cloudglides/FC/FC.png

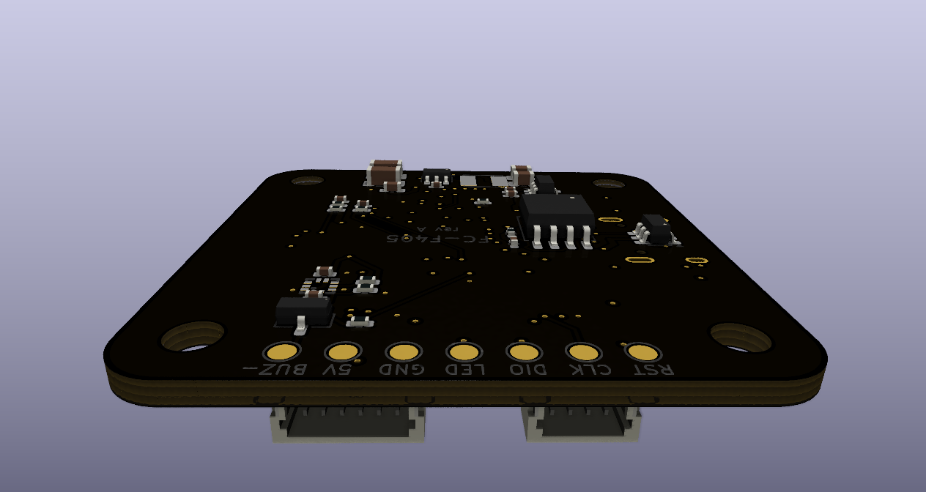
FC.png
