cloudglides/FC/journals/02-sch-parts-arranged-in-blocks/schematic.png

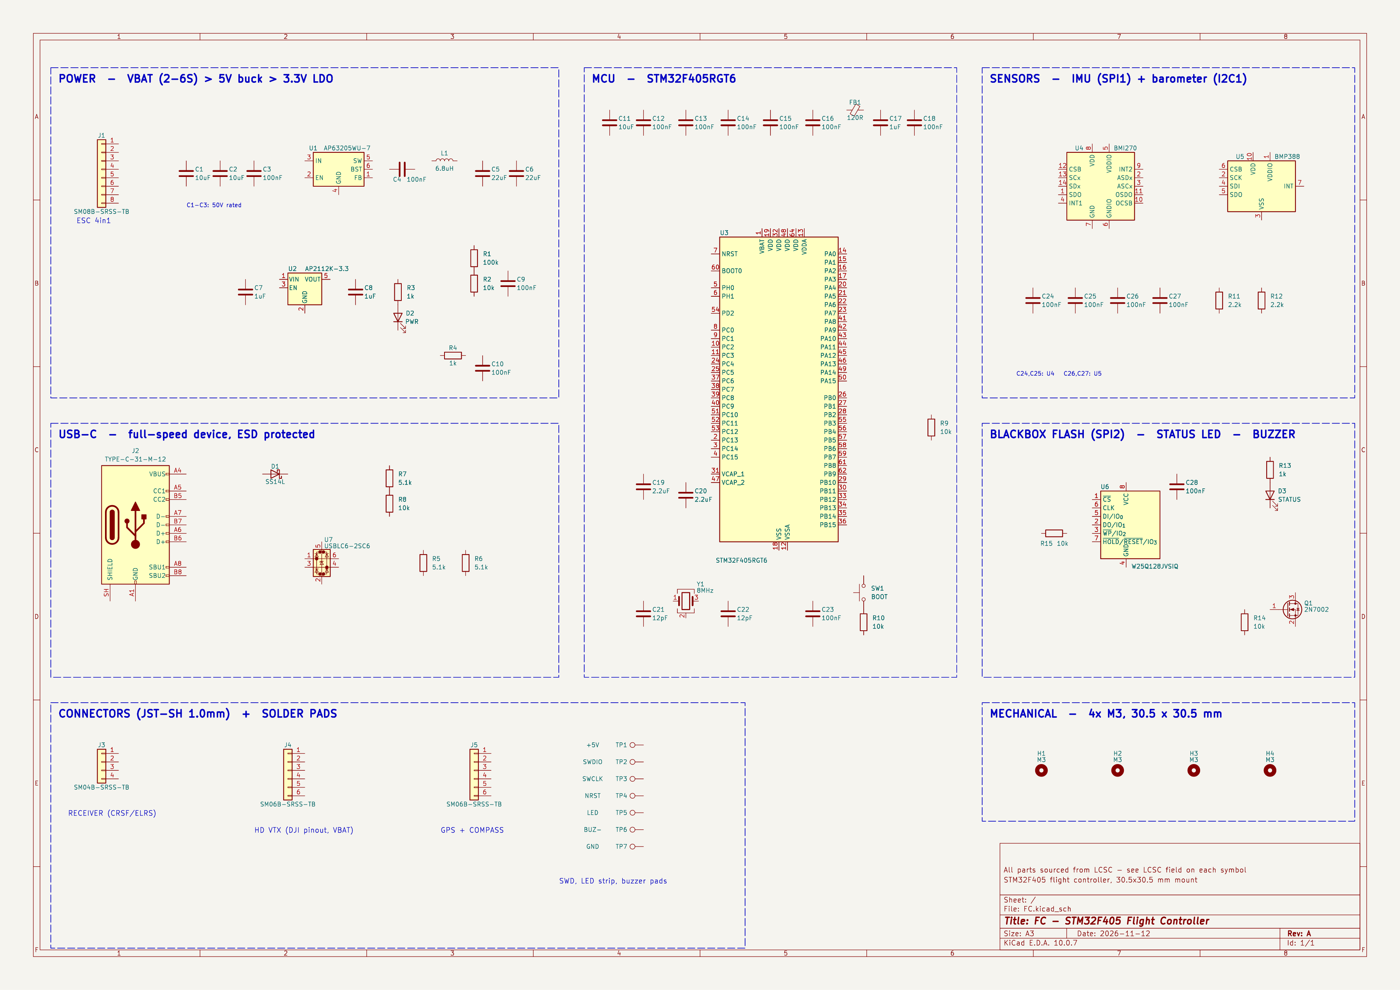
journals/02-sch-parts-arranged-in-blocks/schematic.png
