cloudglides/FC/journals/04-sch-usb-wired/schematic.png

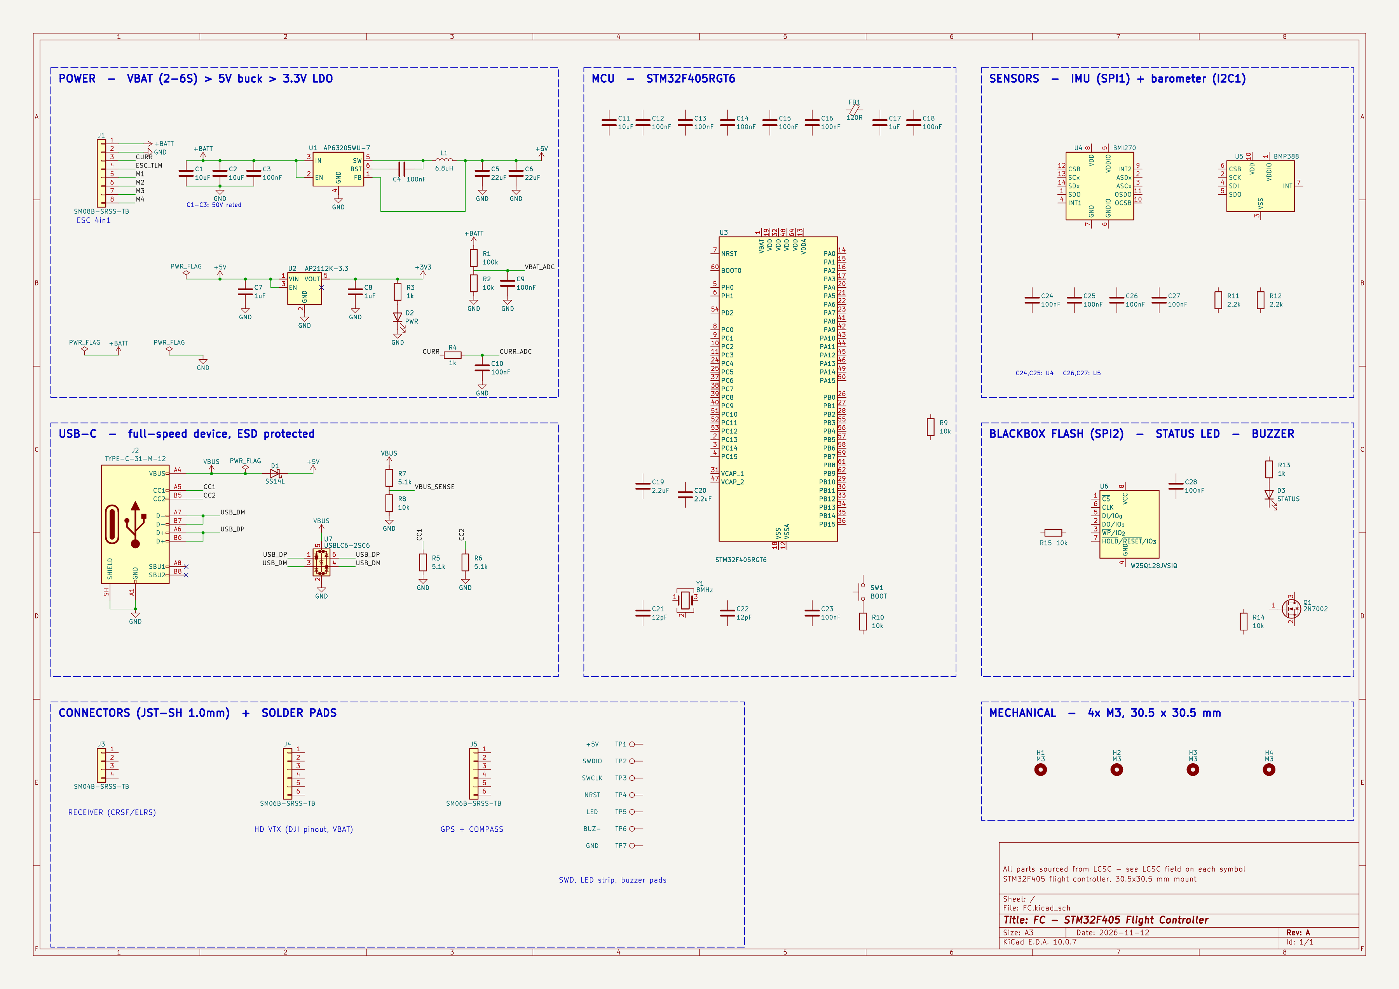
journals/04-sch-usb-wired/schematic.png
