cloudglides/FC/BOM.csv

Comment | Designator | Footprint | LCSC Part # | Quantity
10uF | C1,C2 | C_1206_3216Metric | C77092 | 2
100nF | C3 | C_0603_1608Metric | C14663 | 1
100nF | C4,C9,C10,C12,C13,C14,C15,C16,C18,C23,C24,C25,C26,C27,C28 | C_0402_1005Metric | C1525 | 15
22uF | C5,C6 | C_0805_2012Metric | C45783 | 2
1uF | C7,C8,C17 | C_0402_1005Metric | C52923 | 3
10uF | C11 | C_0603_1608Metric | C19702 | 1
2.2uF | C19,C20 | C_0402_1005Metric | C12530 | 2
12pF | C21,C22 | C_0402_1005Metric | C1547 | 2
SS14L | D1 | D_SOD-123F | C190475 | 1
PWR | D2 | LED_0603_1608Metric | C2290 | 1
STATUS | D3 | LED_0603_1608Metric | C7371904 | 1
120R | FB1 | L_0603_1608Metric | C14709 | 1
SM08B-SRSS-TB | J1 | JST_SH_SM08B-SRSS-TB_1x08-1MP_P1.00mm_Horizontal | C160407 | 1
TYPE-C-31-M-12 | J2 | USB_C_Receptacle_HRO_TYPE-C-31-M-12 | C165948 | 1
SM04B-SRSS-TB | J3 | JST_SH_SM04B-SRSS-TB_1x04-1MP_P1.00mm_Horizontal | C160404 | 1
SM06B-SRSS-TB | J4,J5 | JST_SH_SM06B-SRSS-TB_1x06-1MP_P1.00mm_Horizontal | C160405 | 2
6.8uH | L1 | IND-SMD_L4.0-W4.0 | C843301 | 1
2N7002 | Q1 | SOT-23 | C8545 | 1
100k | R1 | R_0402_1005Metric | C25741 | 1
10k | R2,R8,R9,R10,R14,R15 | R_0402_1005Metric | C60490 | 6
1k | R3,R4,R13 | R_0402_1005Metric | C11702 | 3
5.1k | R5,R6,R7 | R_0402_1005Metric | C25905 | 3
2.2k | R11,R12 | R_0402_1005Metric | C25879 | 2
BOOT | SW1 | SW_Push_1P1T_XKB_TS-1187A | C318884 | 1
AP63205WU-7 | U1 | TSOT-23-6 | C2071056 | 1
AP2112K-3.3 | U2 | SOT-23-5 | C51118 | 1
STM32F405RGT6 | U3 | LQFP-64_10x10mm_P0.5mm | C15742 | 1
BMI270 | U4 | LGA-14_L3.0-W2.5-P0.50-BR | C2836813 | 1
BMP388 | U5 | SENSORM-SMD_BMP388 | C779278 | 1
W25Q128JVSIQ | U6 | SOIC-8_5.3x5.3mm_P1.27mm | C97521 | 1
USBLC6-2SC6 | U7 | SOT-23-6 | C7519 | 1
8MHz | Y1 | Crystal_SMD_3225-4Pin_3.2x2.5mm | C42388155 | 1
