cloudglides/FC/journals/01-sch-parts-dropped/schema.png

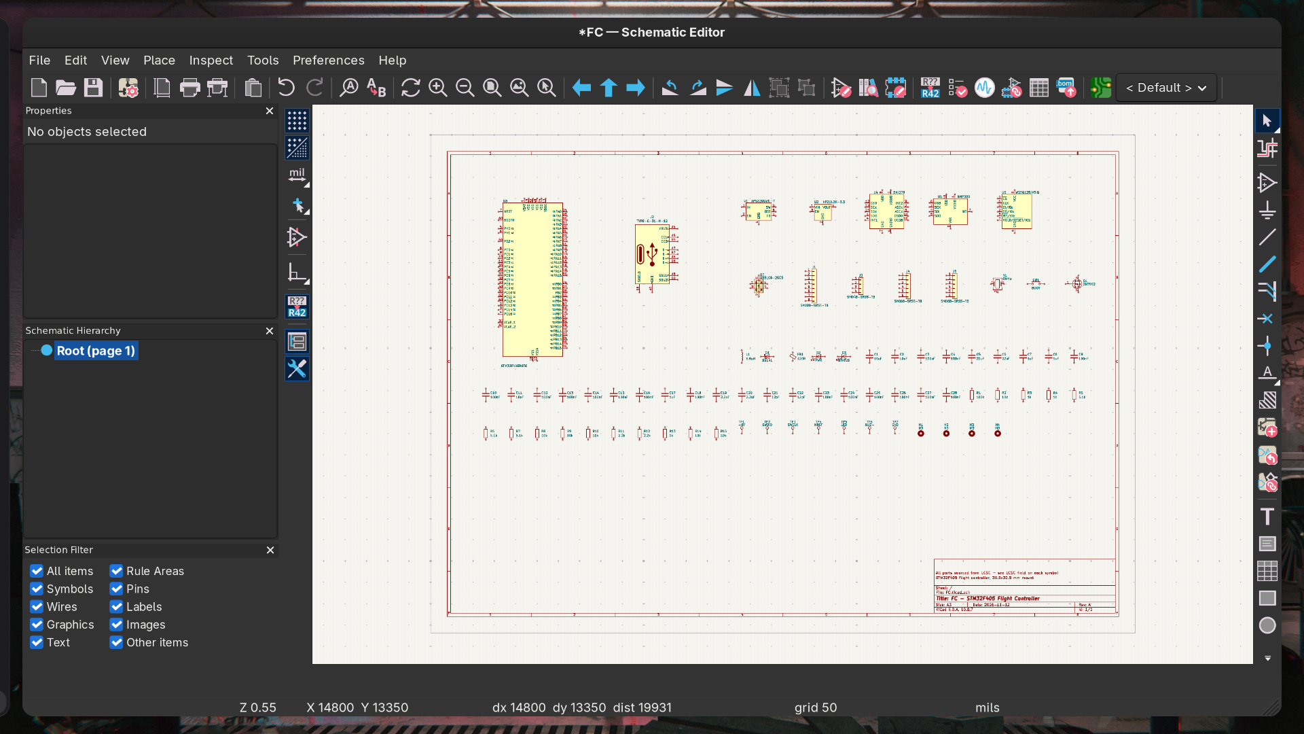
journals/01-sch-parts-dropped/schema.png
