cloudglides/FC/journals/10-pcb-fixed-parts-placed/pcb-bottom.png

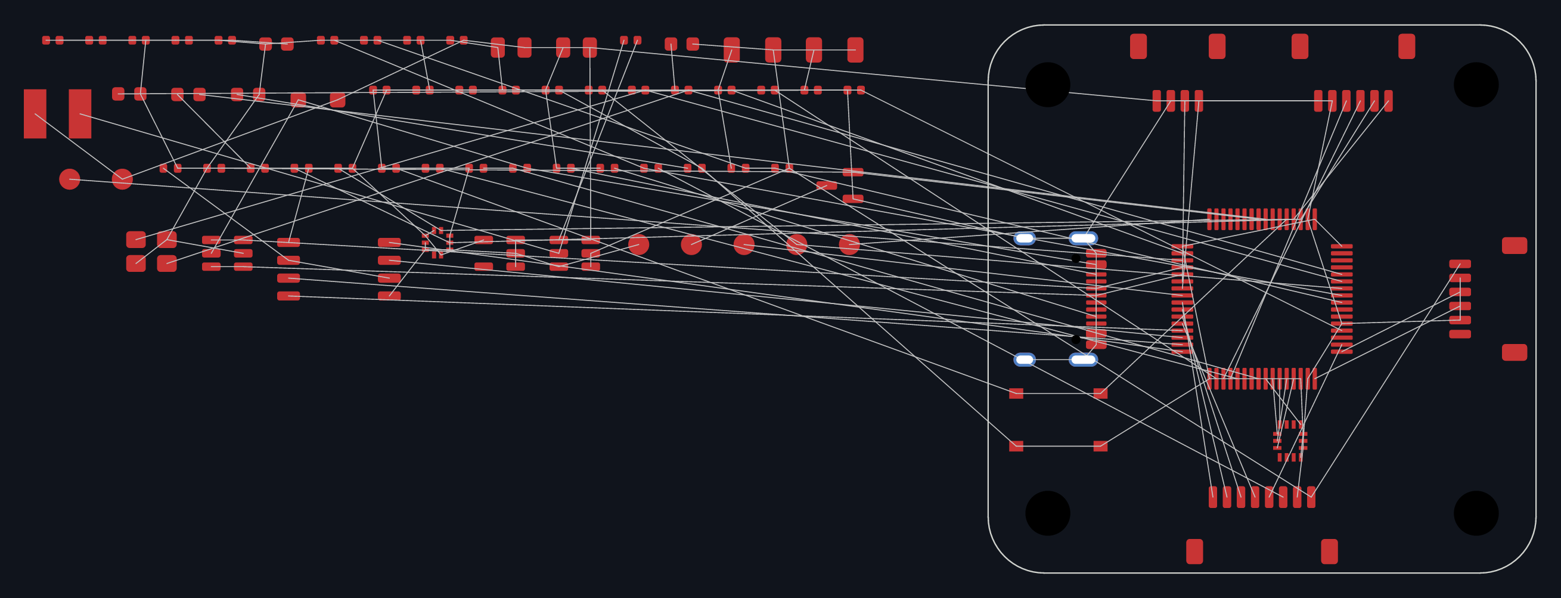
journals/10-pcb-fixed-parts-placed/pcb-bottom.png
