cloudglides/FC/journals/10-pcb-fixed-parts-placed/pcb-top.png

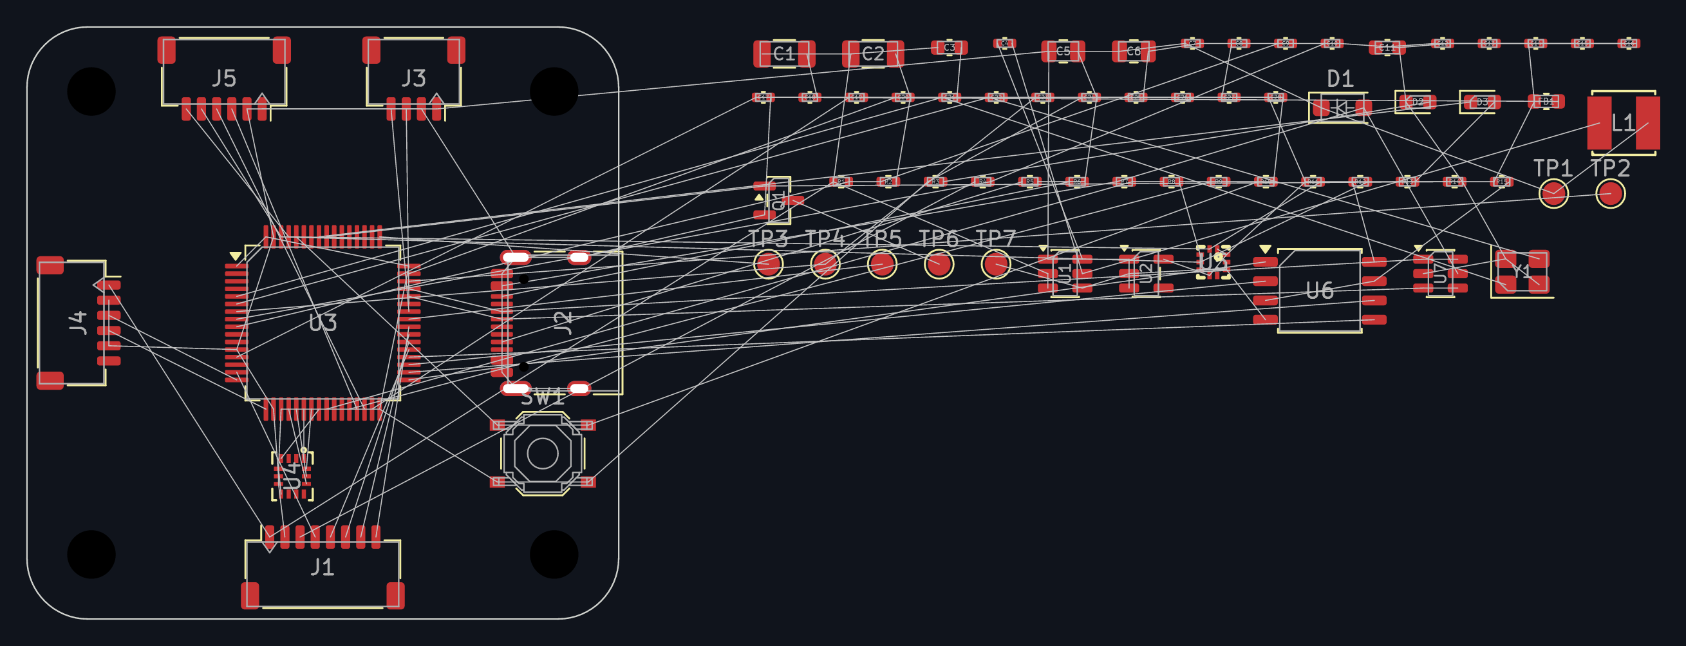
journals/10-pcb-fixed-parts-placed/pcb-top.png
