cloudglides/FC/journals/08-pcb-outline-and-holes/pcb-bottom.png

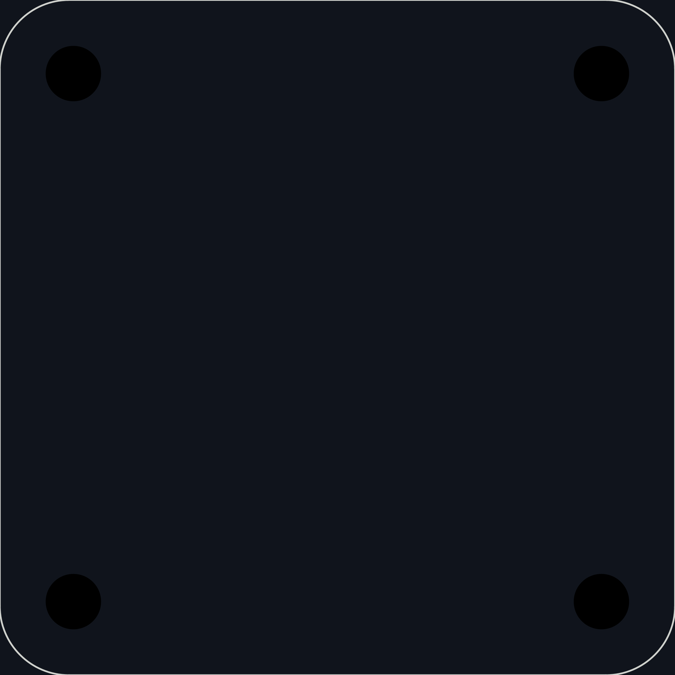
journals/08-pcb-outline-and-holes/pcb-bottom.png
