cloudglides/FC/journals/09-pcb-footprints-imported/pcb-bottom.png

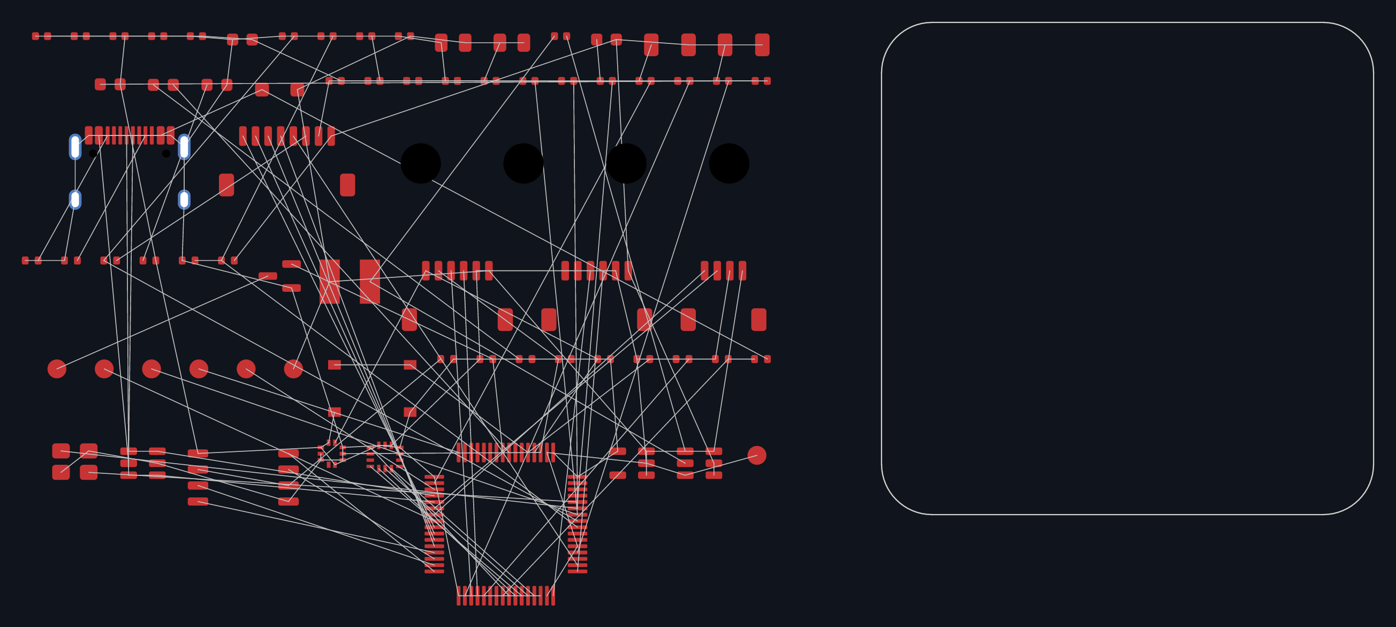
journals/09-pcb-footprints-imported/pcb-bottom.png
