cloudglides/FC/journals/11-pcb-top-side-placed/pcb-bottom.png

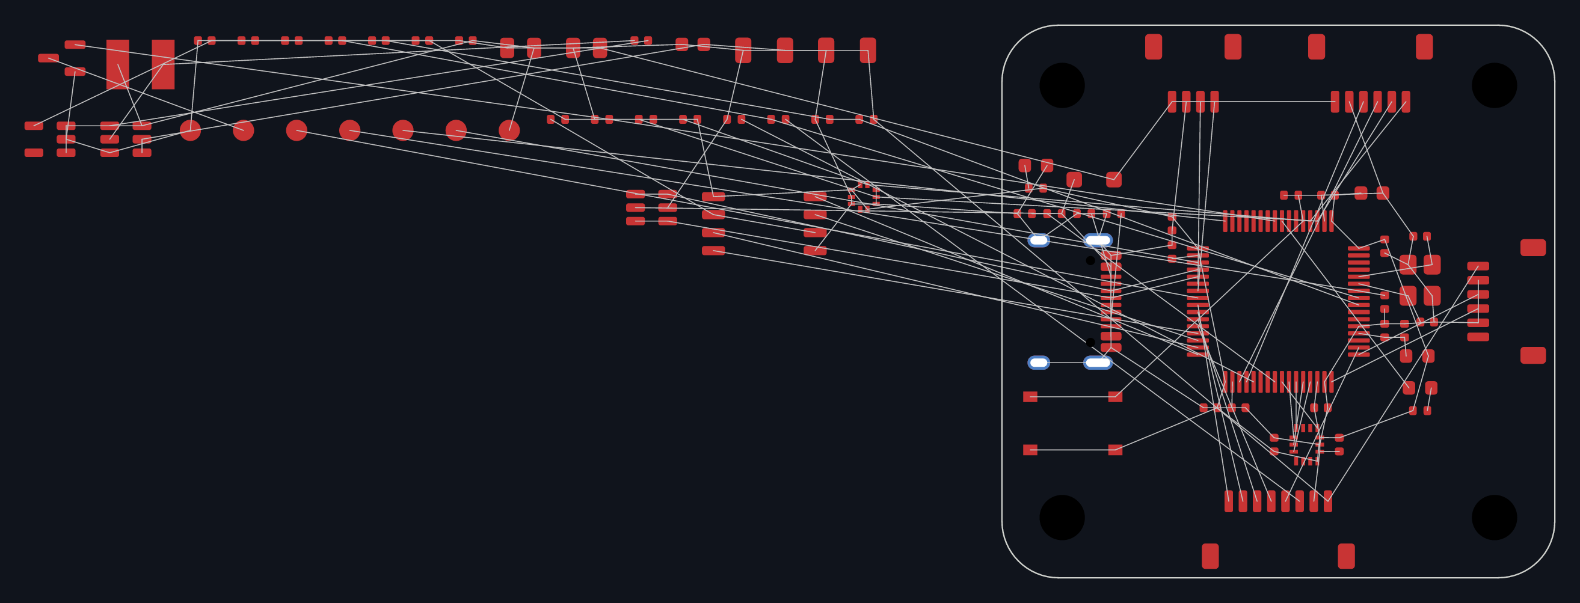
journals/11-pcb-top-side-placed/pcb-bottom.png
