cloudglides/FC/journals/11-pcb-top-side-placed/pcb-top.png

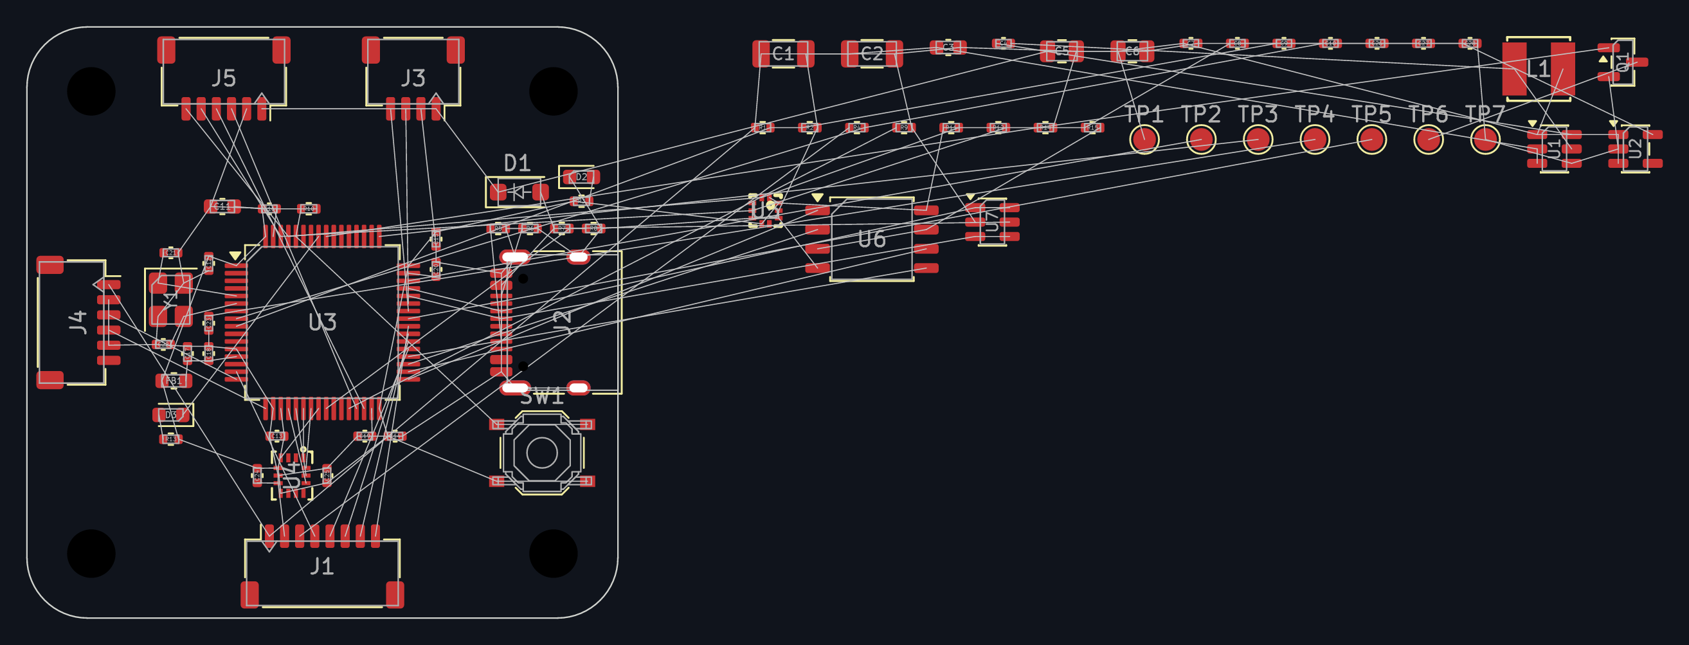
journals/11-pcb-top-side-placed/pcb-top.png
