cloudglides/FC/journals/12-pcb-bottom-side-placed/pcb-bottom.png

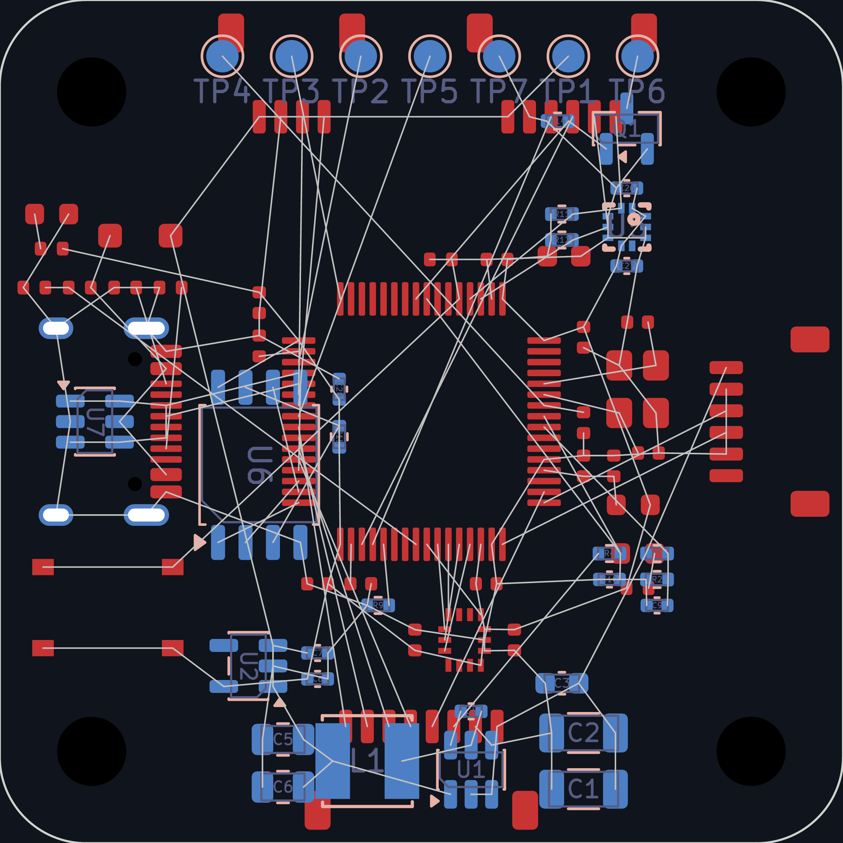
journals/12-pcb-bottom-side-placed/pcb-bottom.png
