cloudglides/FC/journals/13-pcb-power-planes/pcb-inner1-gnd.png

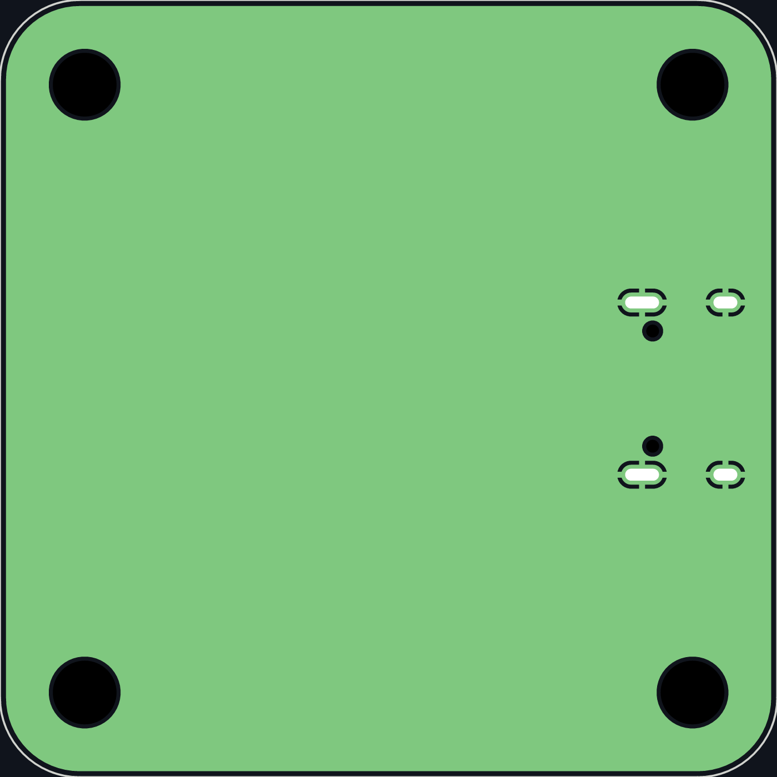
journals/13-pcb-power-planes/pcb-inner1-gnd.png
