cloudglides/FC/journals/14-pcb-routed/pcb-bottom.png

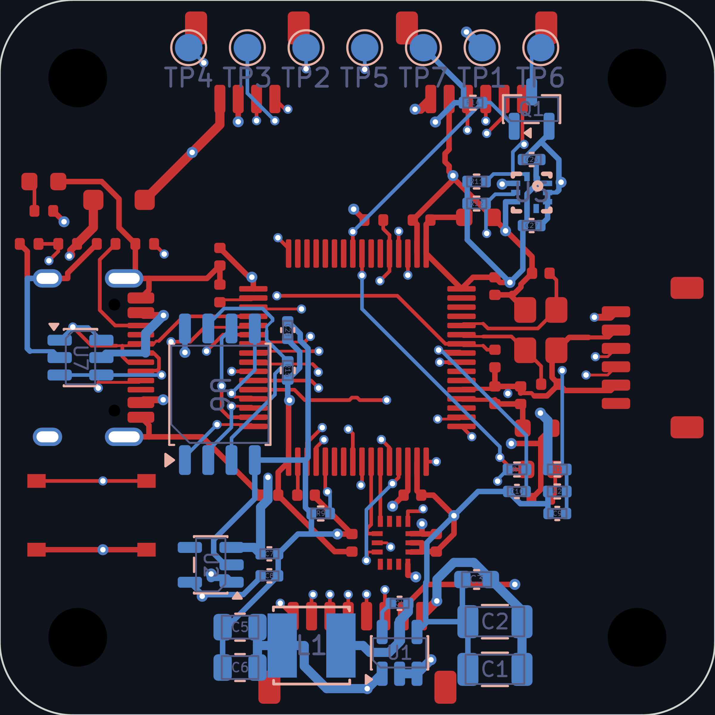
journals/14-pcb-routed/pcb-bottom.png
