cloudglides/FC/docs/FC-schematic.pdf

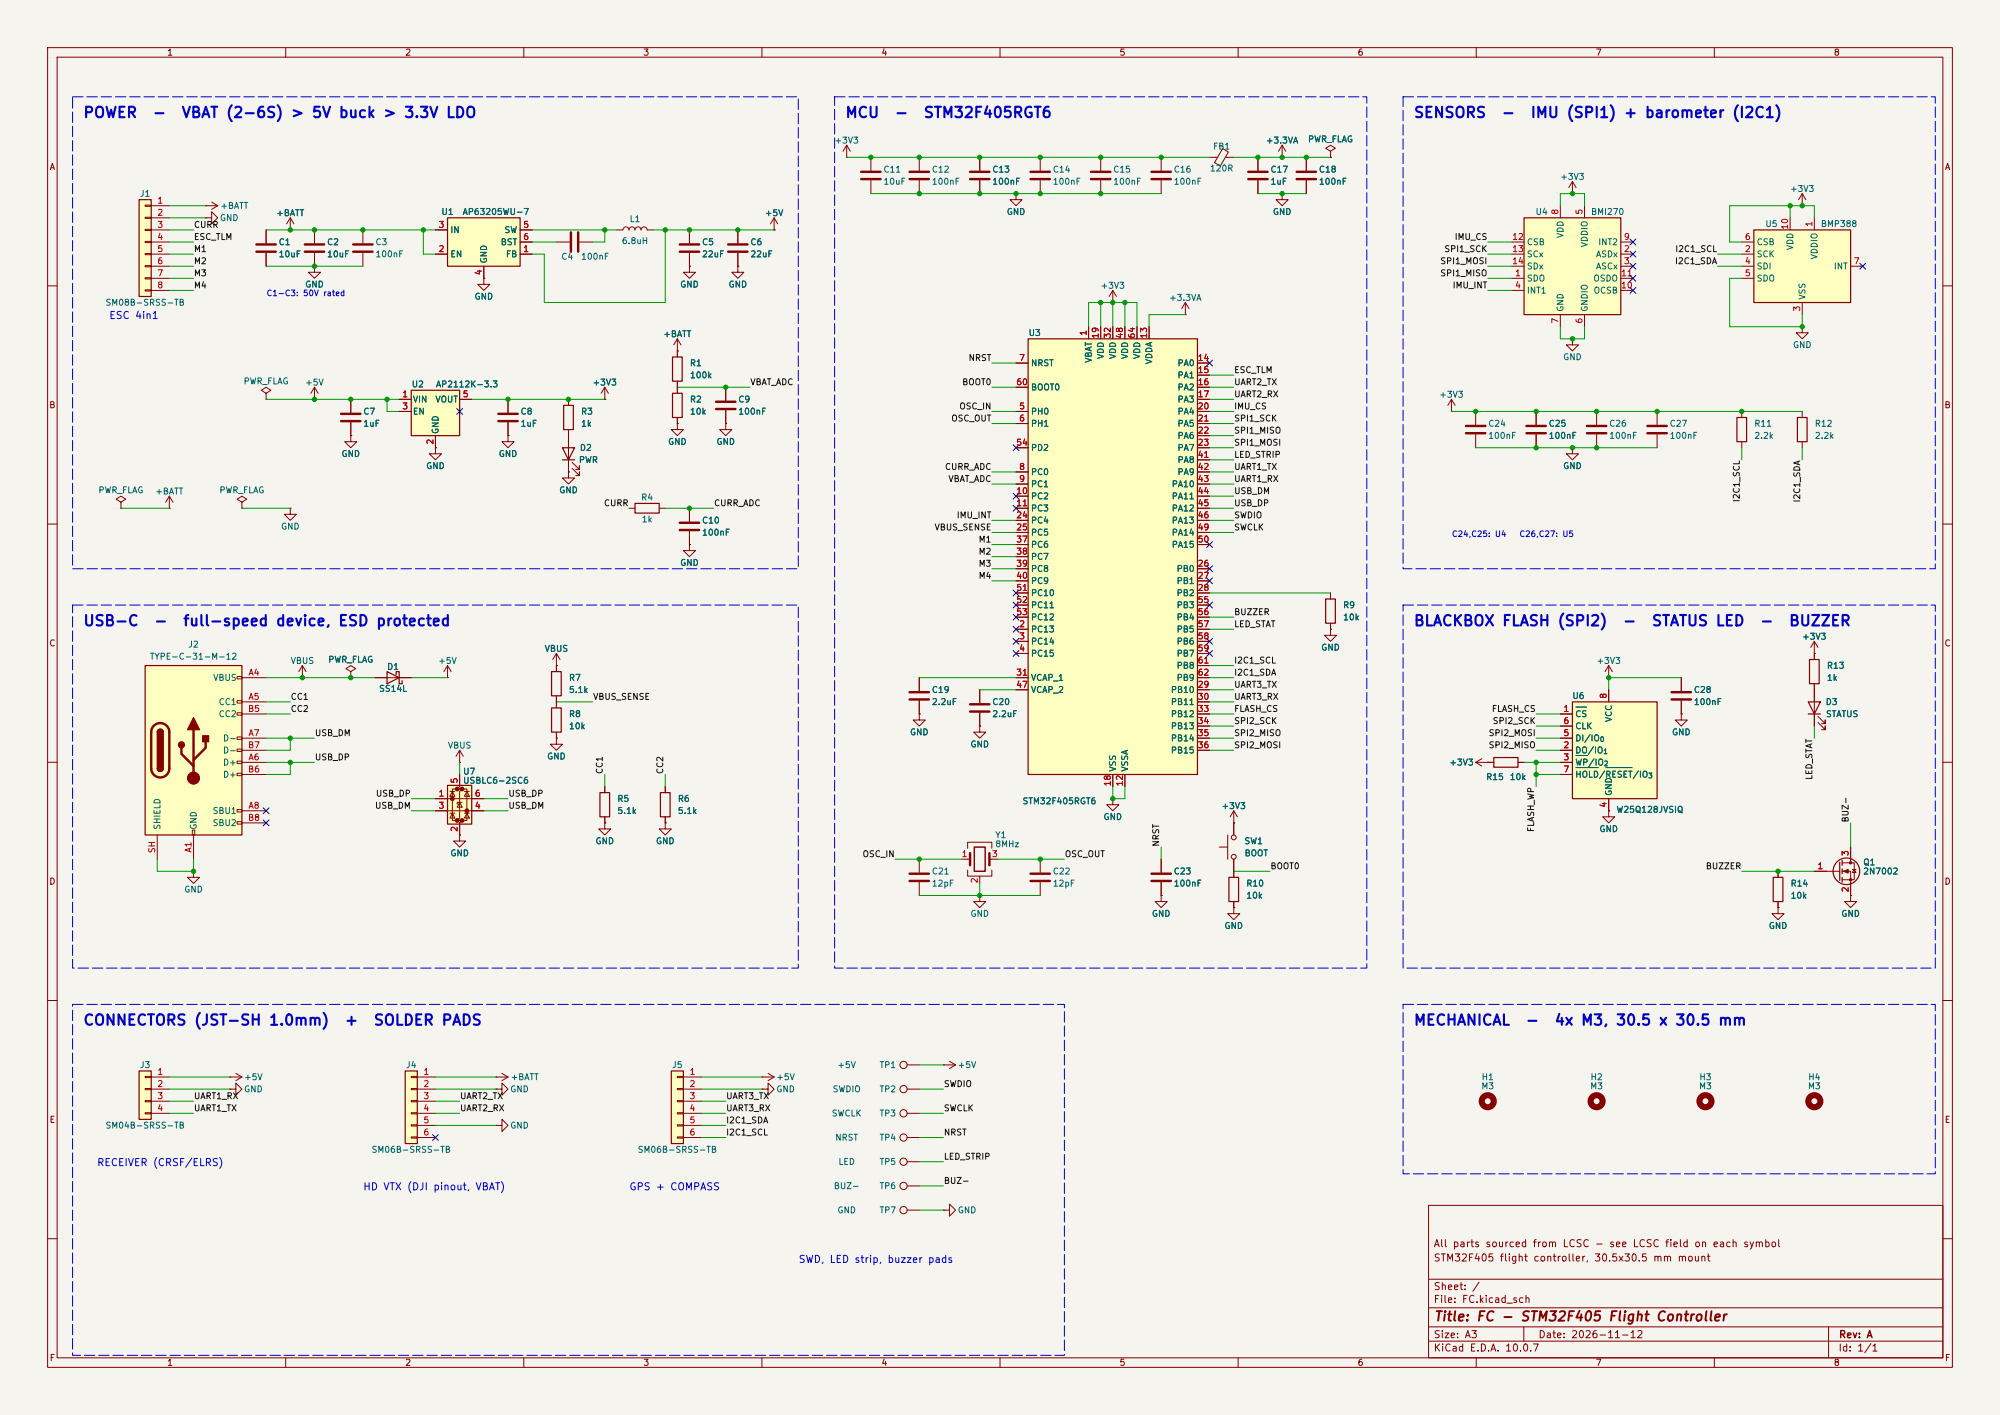
[picture p27: page 1]

POWER - VBAT (2-6S) > 5V buck > 3.3V LDO

USB-C - full-speed device, ESD protected

BLACKBOX FLASH (SPI2) - STATUS LED - BUZZER

4 DI/IO0 5 CLK 6 HOLD/RESET/IO3 7 VCC U6 8 W25Q128JVSIQ

4 DI/IO0 5 CLK 6 HOLD/RESET/IO3 7 VCC

CONNECTORS (JST-SH 1.0mm) + SOLDER PADS

HD VTX (DJI pinout, VBAT)

SWD, LED strip, buzzer pads

STM32F405 flight controller, 30.5x30.5 mm mount

Sheet: /
File: FC.kicad_sch
Title: FC - STM32F405 Flight Controller

Size: A3 | Rev: A | F Date: 2026-11-12
KiCad E.D.A. 10.0.7 | Id: 1/1
