cloudglides/FC/pcb/FC.kicad_pcb

## KiCad design pcb/FC.kicad_pcb (2026-11-12)

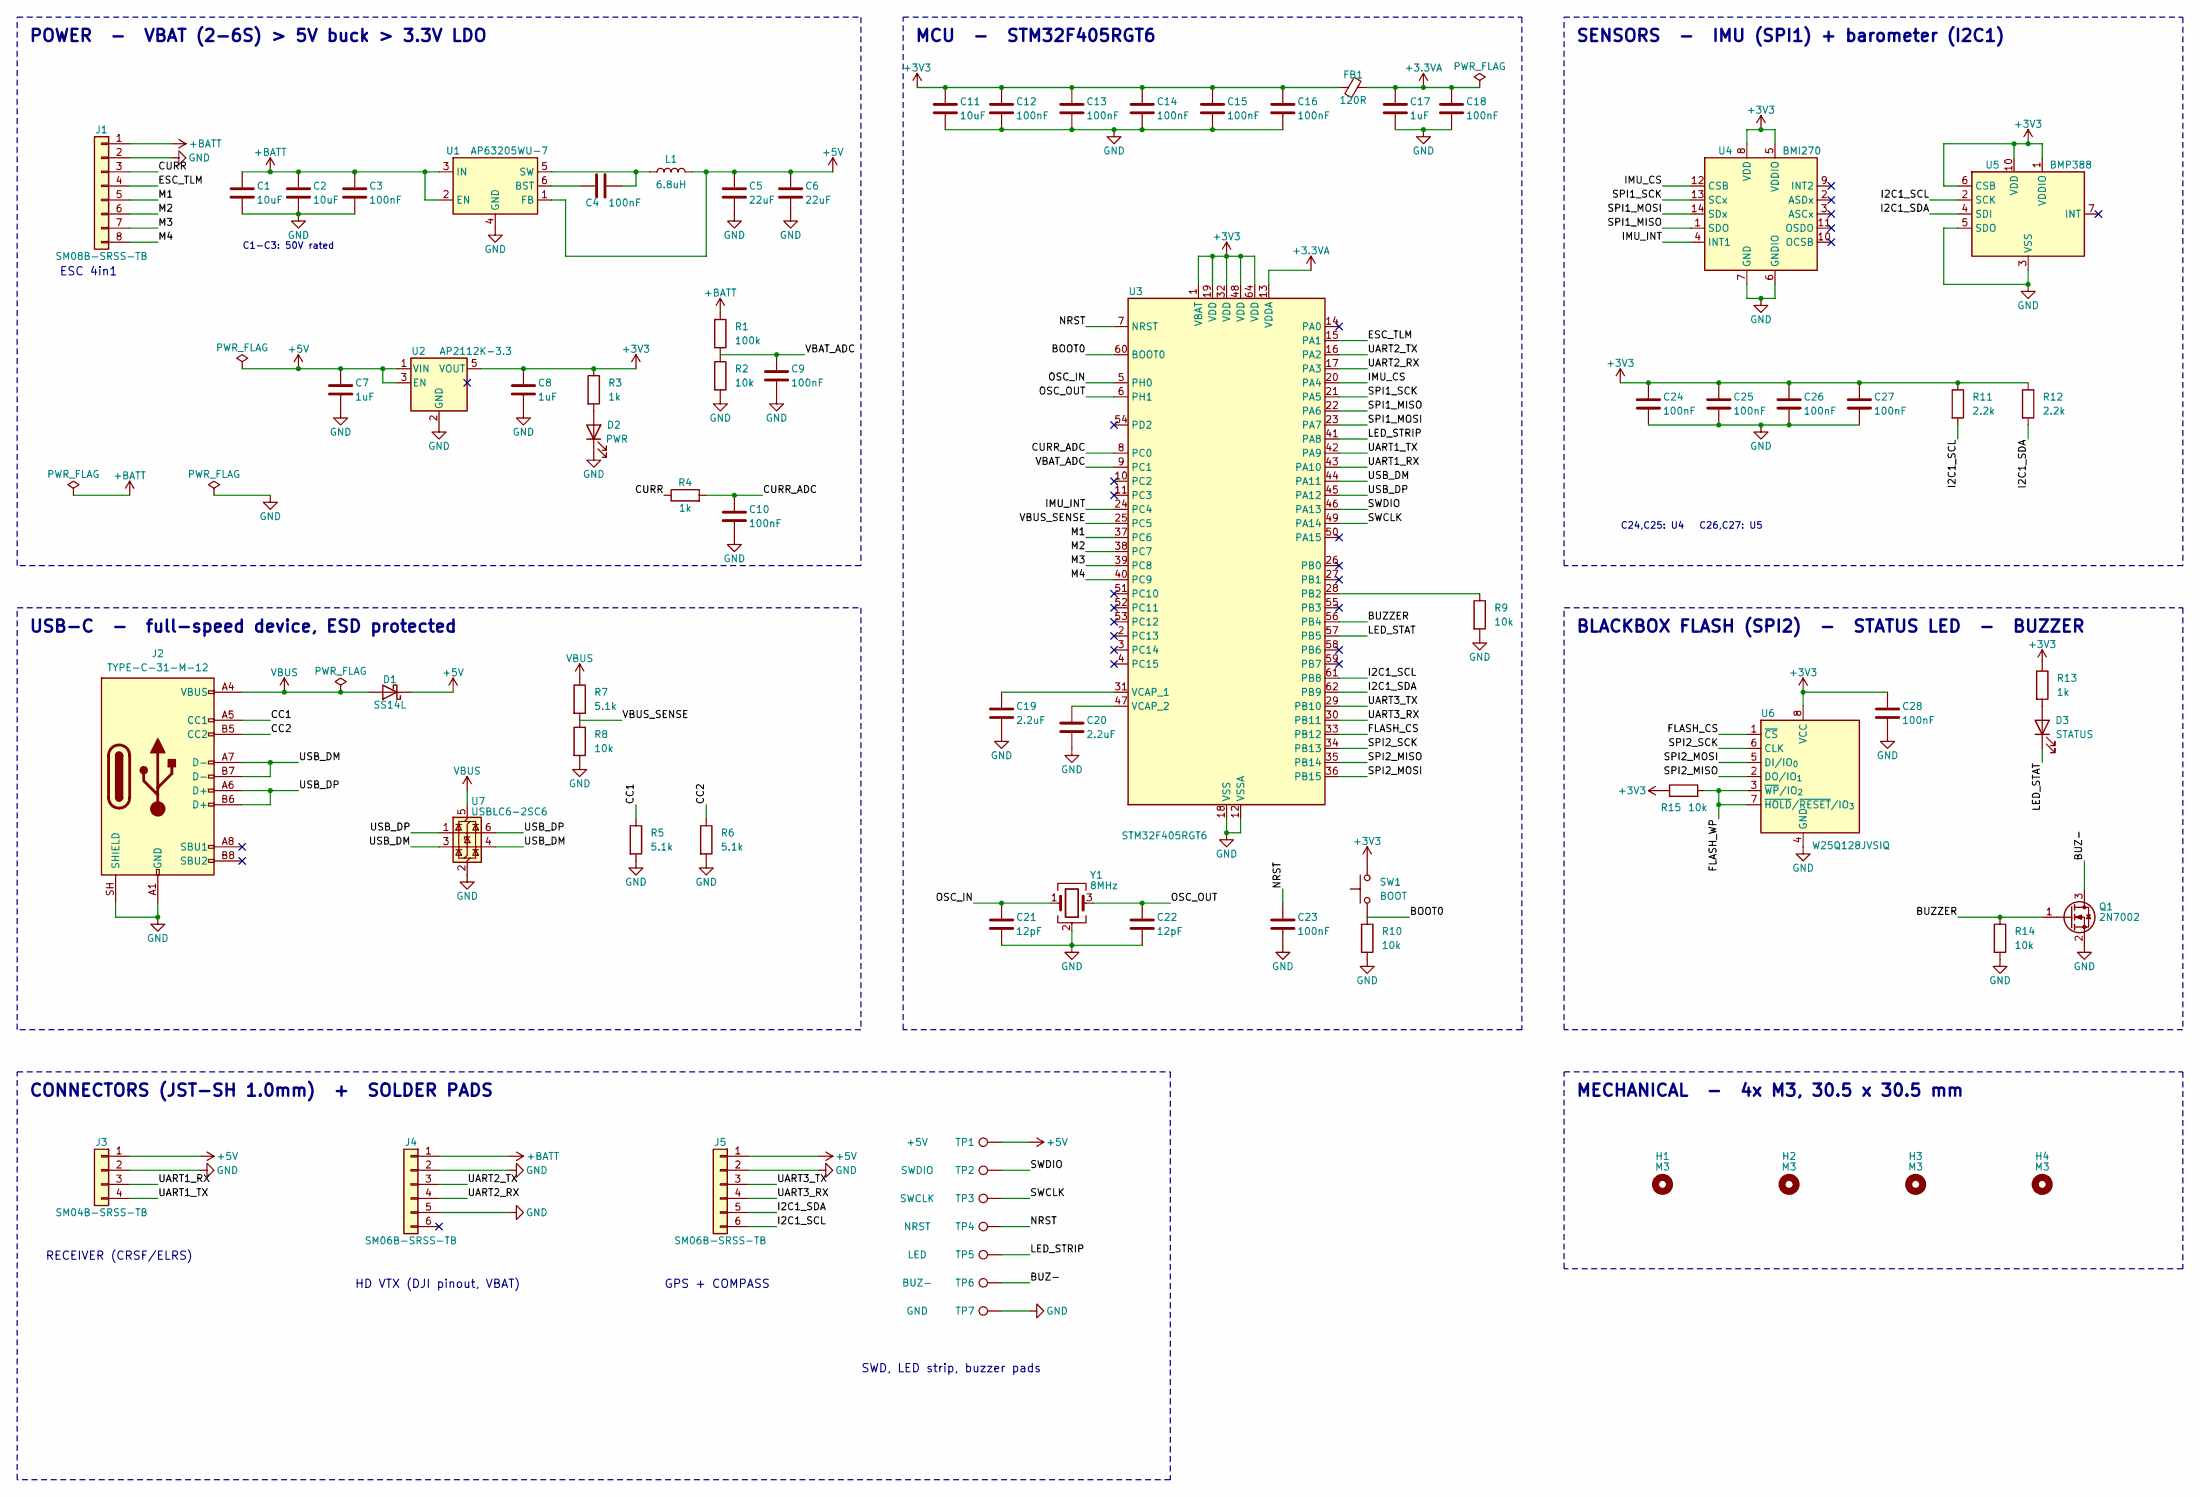
[picture p28: schematic FC.kicad_sch, FC - STM32F405 Flight Controller]

Parts:
C1, C2: 10uF; C_1206_3216Metric; MPN GRM31CR61H106KA12L; LCSC C77092
C3: 100nF; C_0603_1608Metric; MPN CC0603KRX7R9BB104; LCSC C14663
C4, C9, C10, C12, C13, C14, C15, C16, C18, C23, C24, C25, C26, C27, C28: 100nF; C_0402_1005Metric; MPN CL05B104KO5NNNC; LCSC C1525
C5, C6: 22uF; C_0805_2012Metric; MPN CL21A226MAQNNNE; LCSC C45783
C7, C8, C17: 1uF; C_0402_1005Metric; MPN CL05A105KA5NQNC; LCSC C52923
C11: 10uF; C_0603_1608Metric; MPN CL10A106KP8NNNC; LCSC C19702
C19, C20: 2.2uF; C_0402_1005Metric; MPN CL05A225MQ5NSNC; LCSC C12530
C21, C22: 12pF; C_0402_1005Metric; MPN 0402CG120J500NT; LCSC C1547
D1: SS14L; D_SOD-123F; MPN SS14L; LCSC C190475
D2: PWR; LED_0603_1608Metric; MPN KT-0603W; LCSC C2290
D3: STATUS; LED_0603_1608Metric; MPN XL-1608UBC-06A; LCSC C7371904
FB1: 120R; L_0603_1608Metric; MPN BLM18PG121SN1D; LCSC C14709
H1, H2, H3, H4: M3; MountingHole_3.2mm_M3
J1: SM08B-SRSS-TB; JST_SH_SM08B-SRSS-TB_1x08-1MP_P1.00mm_Horizontal; MPN SM08B-SRSS-TB(LF)(SN); LCSC C160407
J2: TYPE-C-31-M-12; USB_C_Receptacle_HRO_TYPE-C-31-M-12; MPN TYPE-C-31-M-12; LCSC C165948
J3: SM04B-SRSS-TB; JST_SH_SM04B-SRSS-TB_1x04-1MP_P1.00mm_Horizontal; MPN SM04B-SRSS-TB(LF)(SN); LCSC C160404
J4, J5: SM06B-SRSS-TB; JST_SH_SM06B-SRSS-TB_1x06-1MP_P1.00mm_Horizontal; MPN SM06B-SRSS-TB(LF)(SN); LCSC C160405
L1: 6.8uH; IND-SMD_L4.0-W4.0; MPN FHD4020S-6R8MT; LCSC C843301
Q1: 2N7002; SOT-23; MPN 2N7002; LCSC C8545
R1: 100k; R_0402_1005Metric; MPN 0402WGF1003TCE; LCSC C25741
R2, R8, R9, R10, R14, R15: 10k; R_0402_1005Metric; MPN RC0402FR-0710KL; LCSC C60490
R3, R4, R13: 1k; R_0402_1005Metric; MPN 0402WGF1001TCE; LCSC C11702
R5, R6, R7: 5.1k; R_0402_1005Metric; MPN 0402WGF5101TCE; LCSC C25905
R11, R12: 2.2k; R_0402_1005Metric; MPN 0402WGF2201TCE; LCSC C25879
SW1: BOOT; SW_Push_1P1T_XKB_TS-1187A; MPN TS-1187A-B-A-B; LCSC C318884
TP1: +5V; TestPoint_Pad_D1.5mm
TP2: SWDIO; TestPoint_Pad_D1.5mm
TP3: SWCLK; TestPoint_Pad_D1.5mm
TP4: NRST; TestPoint_Pad_D1.5mm
TP5: LED; TestPoint_Pad_D1.5mm
TP6: BUZ-; TestPoint_Pad_D1.5mm
TP7: GND; TestPoint_Pad_D1.5mm
U1: AP63205WU-7; TSOT-23-6; MPN AP63205WU-7; LCSC C2071056
U2: AP2112K-3.3; SOT-23-5; MPN AP2112K-3.3TRG1; LCSC C51118
U3: STM32F405RGT6; LQFP-64_10x10mm_P0.5mm; MPN STM32F405RGT6; LCSC C15742
U4: BMI270; LGA-14_L3.0-W2.5-P0.50-BR; MPN BMI270; LCSC C2836813
U5: BMP388; SENSORM-SMD_BMP388; MPN BMP388; LCSC C779278
U6: W25Q128JVSIQ; SOIC-8_5.3x5.3mm_P1.27mm; MPN W25Q128JVSIQ; LCSC C97521
U7: USBLC6-2SC6; SOT-23-6; MPN USBLC6-2SC6; LCSC C7519
Y1: 8MHz; Crystal_SMD_3225-4Pin_3.2x2.5mm; MPN XL2EL89CMI-111YLC-8M; LCSC C42388155

Connections:
+3.3VA: C17.1, C18.1, FB1.2, U3.13 (VDDA)
+3V3: C8.1, C11.1, C12.1, C13.1, C14.1, C15.1, C16.1, C24.1, C25.1, C26.1, C27.1, C28.1, FB1.1, R3.1, R11.1, R12.1, R13.1, R15.1, SW1.2, U2.5 (VOUT), U3.1 (VBAT), U3.19 (VDD), U3.32 (VDD), U3.48 (VDD), U3.64 (VDD), U4.5 (VDDIO), U4.8 (VDD), U5.1 (VDDIO), U5.6 (CSB), U5.10 (VDD), U6.8 (VCC)
+5V: C5.1, C6.1, C7.1, D1.1 (K), J3.1, J5.1, L1.2, TP1.1, U1.1 (FB), U2.1 (VIN), U2.3 (EN)
+BATT: C1.1, C2.1, C3.1, J1.1, J4.1, R1.1, U1.2 (EN), U1.3 (IN)
/BOOT0: R10.1, SW1.1, U3.60 (BOOT0)
/BUZ-: Q1.3 (D), TP6.1
/BUZZER: Q1.1 (G), R14.1, U3.56 (PB4)
/CC1: J2.A5 (CC1), R5.1
/CC2: J2.B5 (CC2), R6.1
/CURR: J1.3, R4.1
/CURR_ADC: C10.1, R4.2, U3.8 (PC0)
/ESC_TLM: J1.4, U3.15 (PA1)
/FLASH_CS: U3.33 (PB12), U6.1 (~CS)
/FLASH_WP: R15.2, U6.3 (~WP/IO_{2}), U6.7 (~HOLD/~RESET/IO_{3})
/I2C1_SCL: J5.6, R11.2, U3.61 (PB8), U5.2 (SCK)
/I2C1_SDA: J5.5, R12.2, U3.62 (PB9), U5.4 (SDI)
/IMU_CS: U3.20 (PA4), U4.12 (CSB)
/IMU_INT: U3.24 (PC4), U4.4 (INT1)
/LED_STAT: D3.1 (K), U3.57 (PB5)
/LED_STRIP: TP5.1, U3.41 (PA8)
/M1: J1.5, U3.37 (PC6)
/M2: J1.6, U3.38 (PC7)
/M3: J1.7, U3.39 (PC8)
/M4: J1.8, U3.40 (PC9)
/NRST: C23.1, TP4.1, U3.7 (NRST)
/OSC_IN: C21.1, U3.5 (PH0), Y1.1
/OSC_OUT: C22.1, U3.6 (PH1), Y1.3
/SPI1_MISO: U3.22 (PA6), U4.1 (SDO)
/SPI1_MOSI: U3.23 (PA7), U4.14 (SDx)
/SPI1_SCK: U3.21 (PA5), U4.13 (SCx)
/SPI2_MISO: U3.35 (PB14), U6.2 (DO/IO_{1})
/SPI2_MOSI: U3.36 (PB15), U6.5 (DI/IO_{0})
/SPI2_SCK: U3.34 (PB13), U6.6 (CLK)
/SWCLK: TP3.1, U3.49 (PA14)
/SWDIO: TP2.1, U3.46 (PA13)
/UART1_RX: J3.3, U3.43 (PA10)
/UART1_TX: J3.4, U3.42 (PA9)
/UART2_RX: J4.4, U3.17 (PA3)
/UART2_TX: J4.3, U3.16 (PA2)
/UART3_RX: J5.4, U3.30 (PB11)
/UART3_TX: J5.3, U3.29 (PB10)
/USB_DM: J2.A7 (D-), J2.B7 (D-), U3.44 (PA11), U7.3 (I/O2), U7.4 (I/O2)
/USB_DP: J2.A6 (D+), J2.B6 (D+), U3.45 (PA12), U7.1 (I/O1), U7.6 (I/O1)
/VBAT_ADC: C9.1, R1.2, R2.1, U3.9 (PC1)
/VBUS_SENSE: R7.2, R8.1, U3.25 (PC5)
GND: C1.2, C2.2, C3.2, C5.2, C6.2, C7.2, C8.2, C9.2, C10.2, C11.2, C12.2, C13.2, C14.2, C15.2, C16.2, C17.2, C18.2, C19.2, C20.2, C21.2, C22.2, C23.2, C24.2, C25.2, C26.2, C27.2, C28.2, D2.1 (K), J1.2, J2.A1 (GND), J2.A12 (GND), J2.B1 (GND), J2.B12 (GND), J2.SH (SHIELD), J3.2, J4.2, J4.5, J5.2, Q1.2 (S), R2.2, R5.2, R6.2, R8.2, R9.2, R10.2, R14.2, TP7.1, U1.4 (GND), U2.2 (GND), U3.12 (VSSA), U3.18 (VSS), U3.63 (VSS), U4.6 (GNDIO), U4.7 (GND), U5.3 (VSS), U5.5 (SDO), U5.8 (VSS), U5.9 (VSS), U6.4 (GND), U7.2 (GND), Y1.2 (G), Y1.4 (G)
unnamed: D2.2 (A), R3.2
unnamed: D3.2 (A), R13.2
unnamed: C4.1, U1.6 (BST)
unnamed: C4.2, L1.1, U1.5 (SW)
unnamed: R9.1, U3.28 (PB2)
unnamed: C19.1, U3.31 (VCAP_1)
unnamed: C20.1, U3.47 (VCAP_2)
VBUS: D1.2 (A), J2.A4 (VBUS), J2.A9 (VBUS), J2.B4 (VBUS), J2.B9 (VBUS), R7.1, U7.5 (VBUS)

Notes on the sheet:
POWER - VBAT (2-6S) > 5V buck > 3.3V LDO
ESC 4in1
C1-C3: 50V rated
USB-C - full-speed device, ESD protected
MCU - STM32F405RGT6
SENSORS - IMU (SPI1) + barometer (I2C1)
C24,C25: U4 C26,C27: U5
BLACKBOX FLASH (SPI2) - STATUS LED - BUZZER
CONNECTORS (JST-SH 1.0mm) + SOLDER PADS
RECEIVER (CRSF/ELRS)
HD VTX (DJI pinout, VBAT)
GPS + COMPASS
SWD, LED strip, buzzer pads
MECHANICAL - 4x M3, 30.5 x 30.5 mm

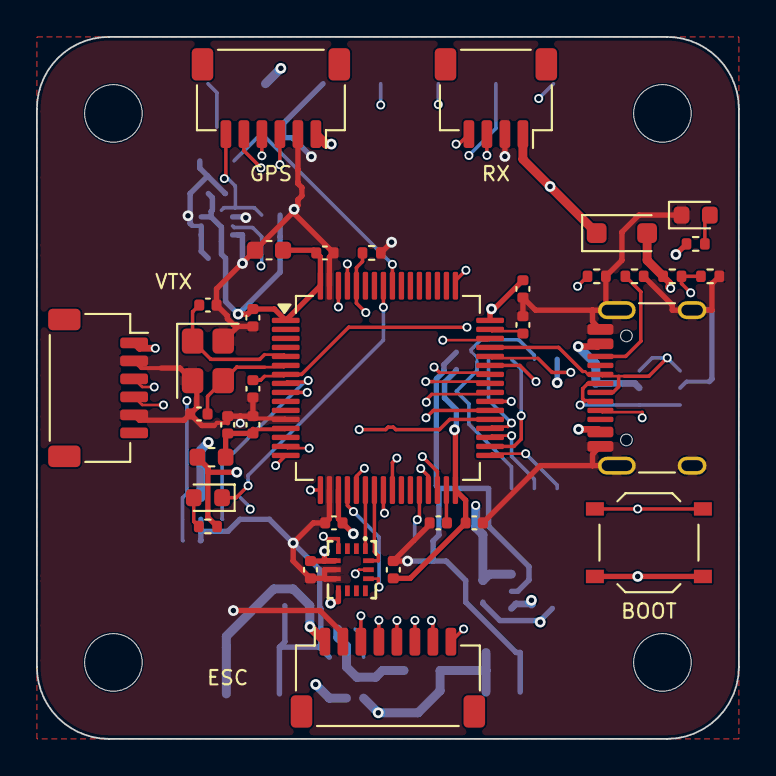
[picture p29: board FC.kicad_pcb from above]

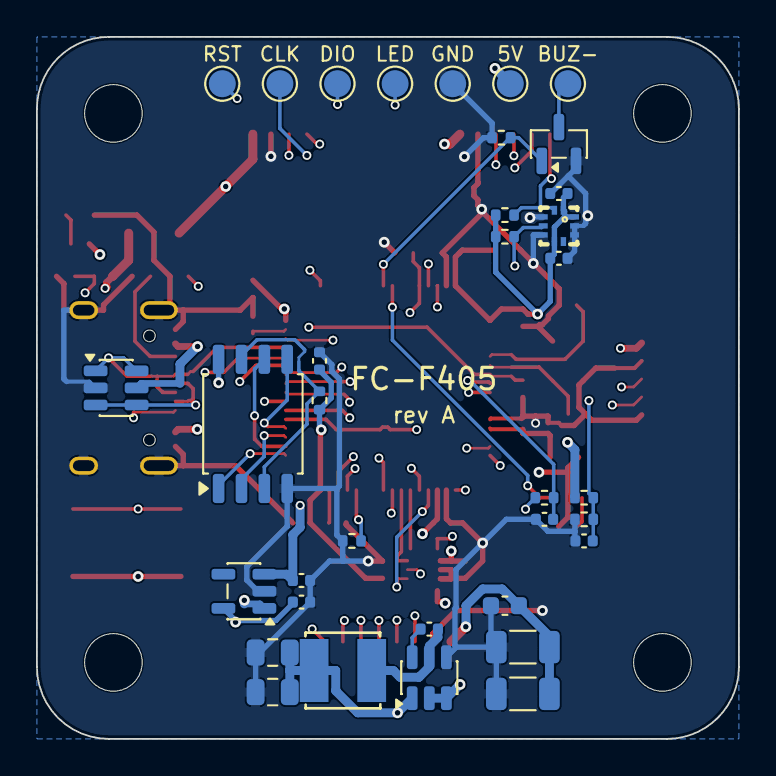
[picture p30: board FC.kicad_pcb from below]

Board: 4 copper layers, 39.0 x 39.0 mm, 74 parts (35 on the bottom side), 54 nets.
